zynthian/zynthian-pedals/README.md

# zynthian-pedals
Zynthian pedals: sustain, momentary switches, etc.
