zynthian/zynthian-pedals/sustain-pedal/phono jack.jpg

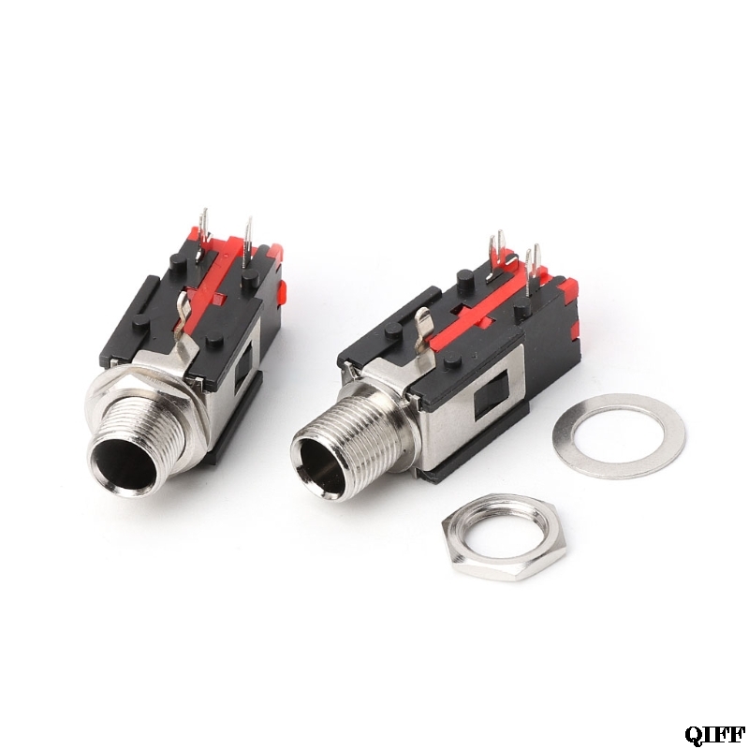
sustain-pedal/phono jack.jpg
