zynthian/zynthian-pedals/sustain-pedal/Pedal.dxf

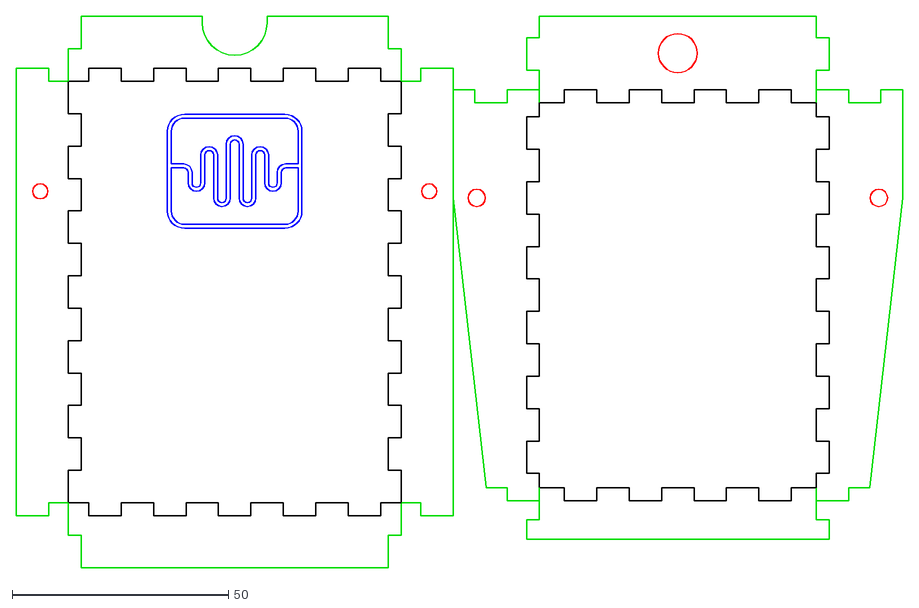
[picture p7: CAD file, 2019-10-29]
sustain-pedal/Pedal.dxf
205.0 x 127.5
