zynthian/zynthian-pedals/SwitchBox/SwitchBox.dxf

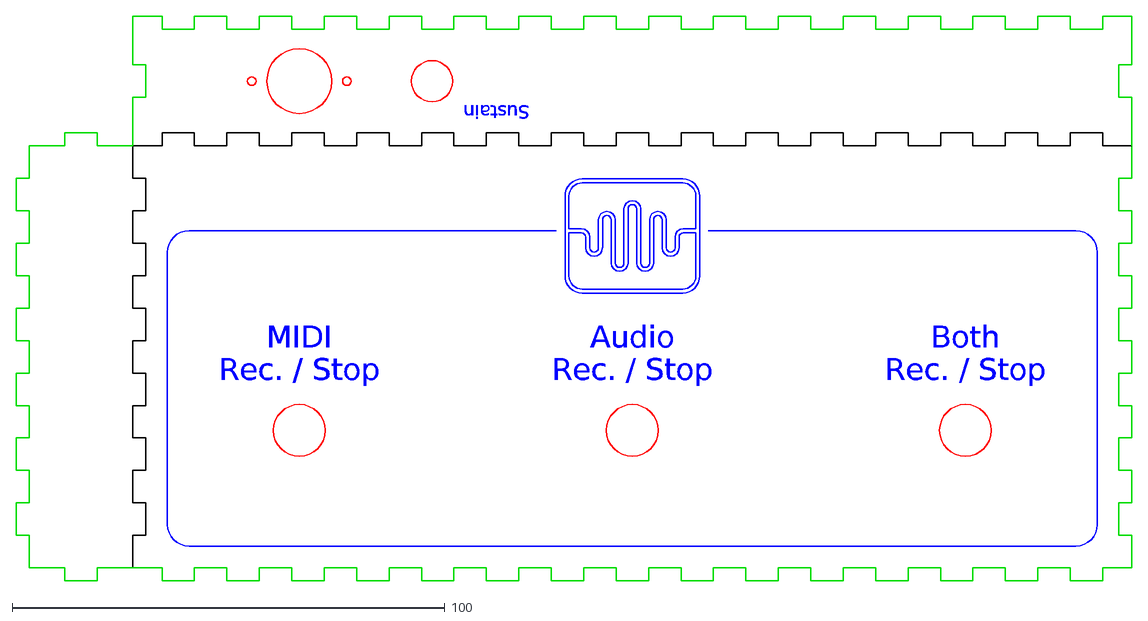
[picture p8: CAD file, 2019-11-11]
SwitchBox/SwitchBox.dxf
MIDI
Rec. / Stop
Audio
Both
Sustain
