zynthian/zynthian-pedals/(commit log)

2019-10-29 initial commit
    Added sustain pedal files and readme assembly instructions.
    [Pedal.dxf]
2019-11-11 Switch Box files added
    initial commit
    [SwitchBox.dxf]
